hssnadr/HTBX_01Ressources/README.md

# HTBX_01Ressources
Hitbox documentation and file ressources
