hssnadr/HTBX_01Ressources/01_Documentation/Hitbox_Dimensions.jpg

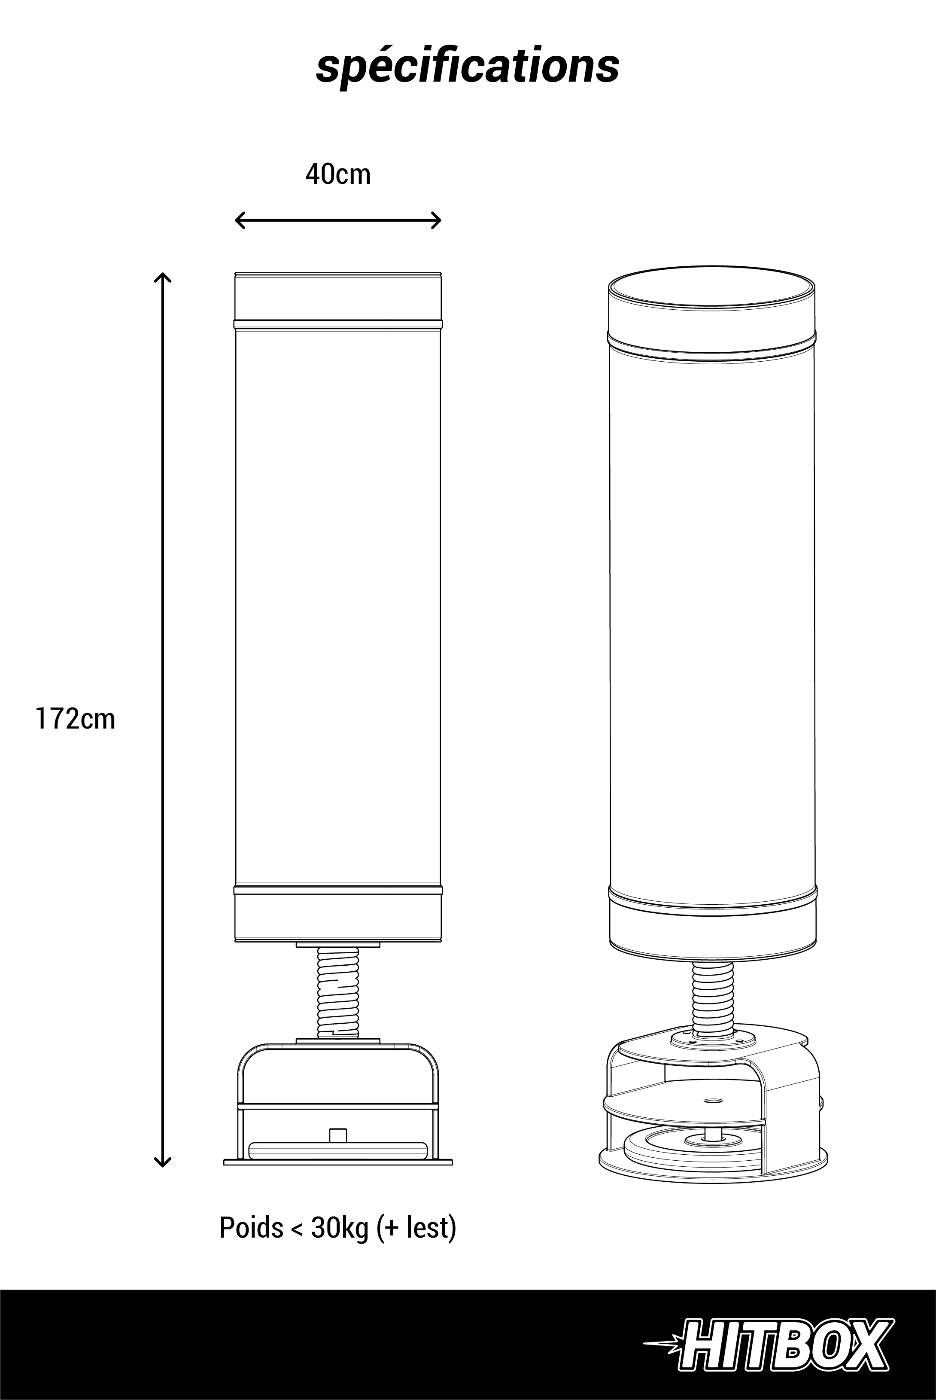
01_Documentation/Hitbox_Dimensions.jpg
