hssnadr/HTBX_01Ressources/01_Documentation/Hitbox_ElectronicsOverview_Display.png

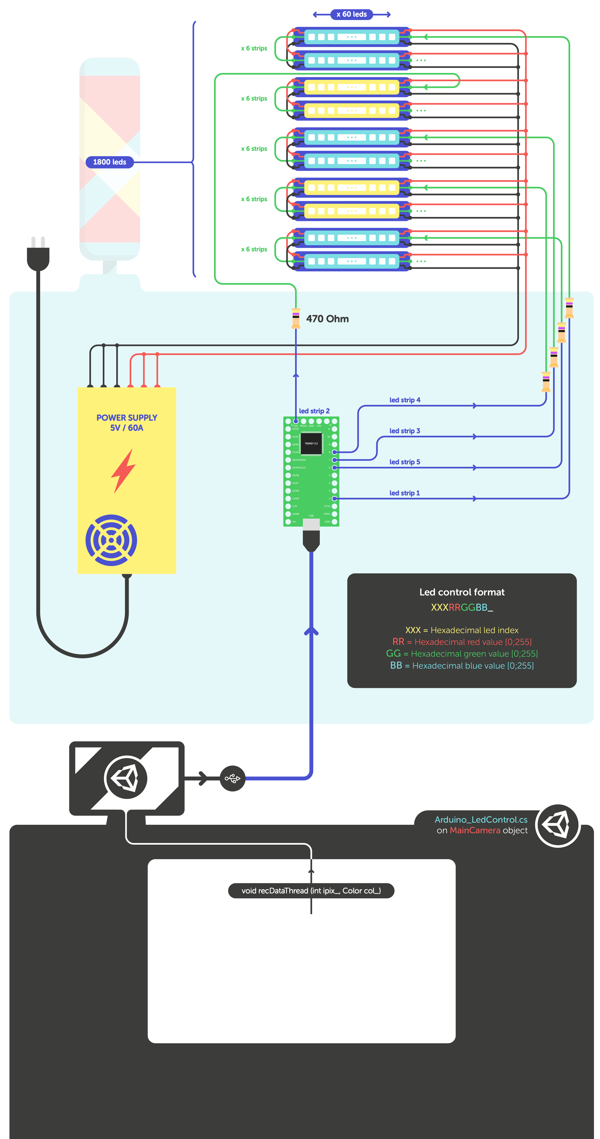
01_Documentation/Hitbox_ElectronicsOverview_Display.png
