hssnadr/HTBX_01Ressources/01_Documentation/Hitbox_ElectronicsOverview_Sensors.png

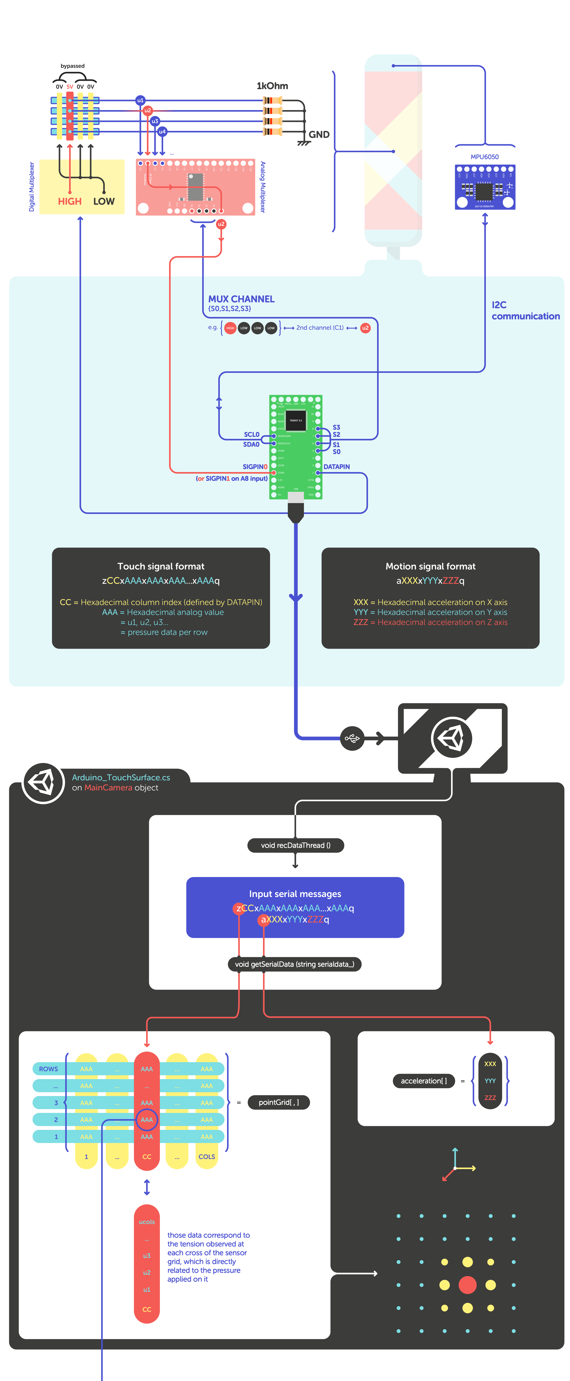
01_Documentation/Hitbox_ElectronicsOverview_Sensors.png
