hssnadr/HTBX_01Ressources/01_Documentation/Hitbox_TechnicOverview.jpg

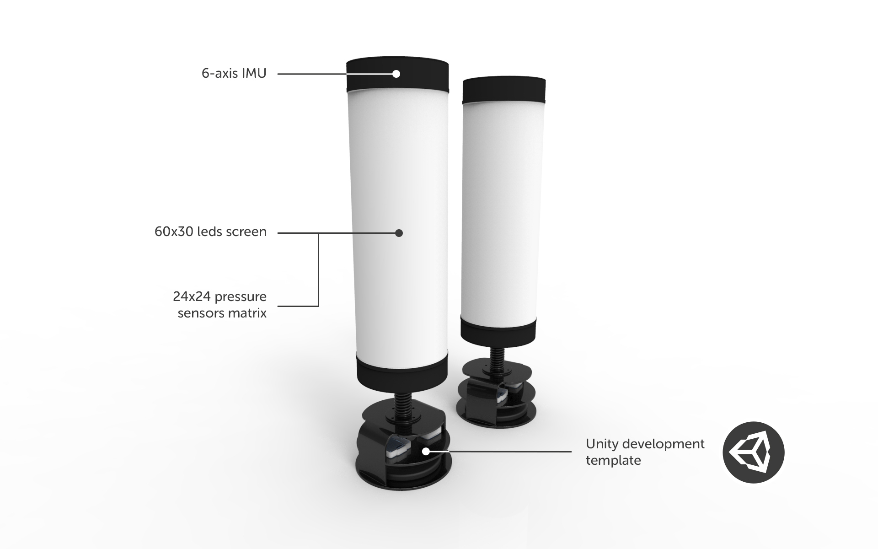
01_Documentation/Hitbox_TechnicOverview.jpg
