hssnadr/HTBX_01Ressources/02_MakingRessources/_CAO/HTBX_EntretoiseTendeurs.stl

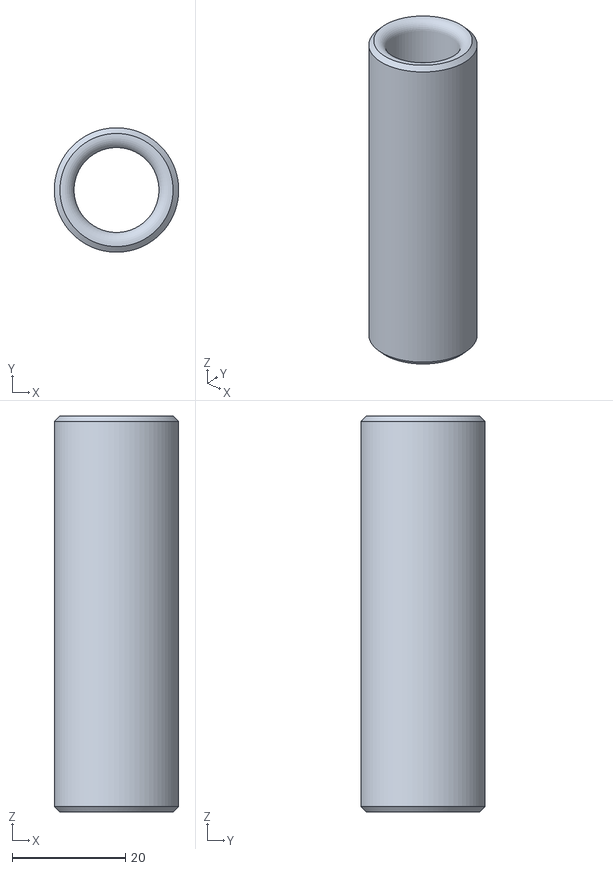
[picture p5: CAD file, 2020-06-24]
02_MakingRessources/_CAO/HTBX_EntretoiseTendeurs.stl
22.0 x 22.0 x 70.0
