hssnadr/HTBX_01Ressources/02_MakingRessources/_CAO/POWER_BOARD/HitBoxV0.31-Powaa.step

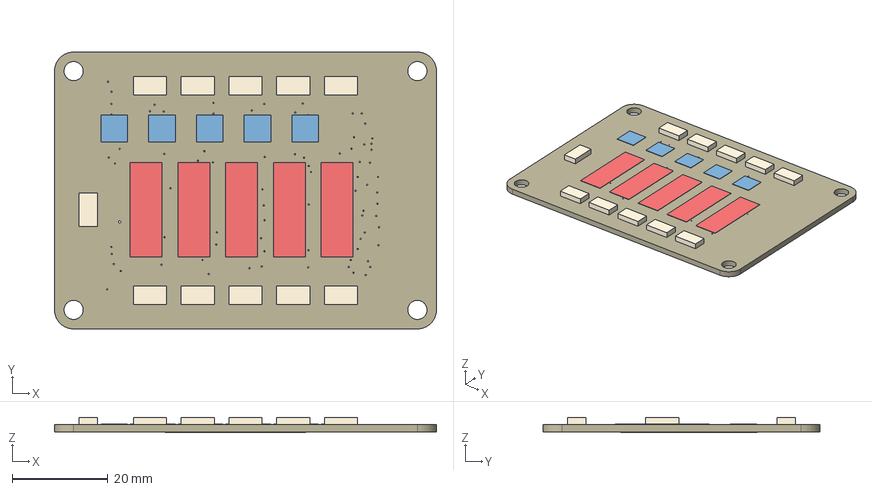
[picture p6: CAD file, 2020-07-23]
02_MakingRessources/_CAO/POWER_BOARD/HitBoxV0.31-Powaa.step
80.0 x 58.0 x 3.18 mm
Board
E2,5-6E x 5
MSTBA2 x 11
LOGO-CRI-NEW-130MMX30MM-TPLACE
FUSE x 5
