hssnadr/HTBX_01Ressources/02_MakingRessources/A_ControlBoardCase/Hitbox_ControlBoardCase_3DPrint.stl

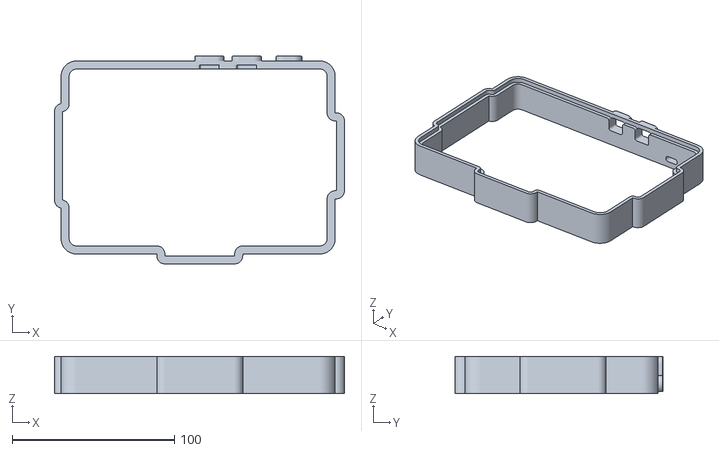
[picture p7: CAD file, 2020-06-19]
02_MakingRessources/A_ControlBoardCase/Hitbox_ControlBoardCase_3DPrint.stl
178.8 x 128.1 x 23.0
