hssnadr/HTBX_01Ressources/02_MakingRessources/B_PowerBoardCase/Hitbox_PowerBoardCase_3DPrint.stl

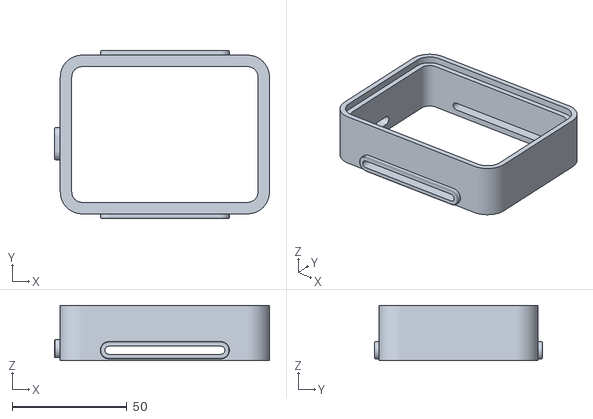
[picture p8: CAD file, 2020-06-19]
02_MakingRessources/B_PowerBoardCase/Hitbox_PowerBoardCase_3DPrint.stl
93.5 x 73.0 x 24.0
