hssnadr/HTBX_01Ressources/02_MakingRessources/C_TopPlatform/TopPlatform_Plexiglass.dxf

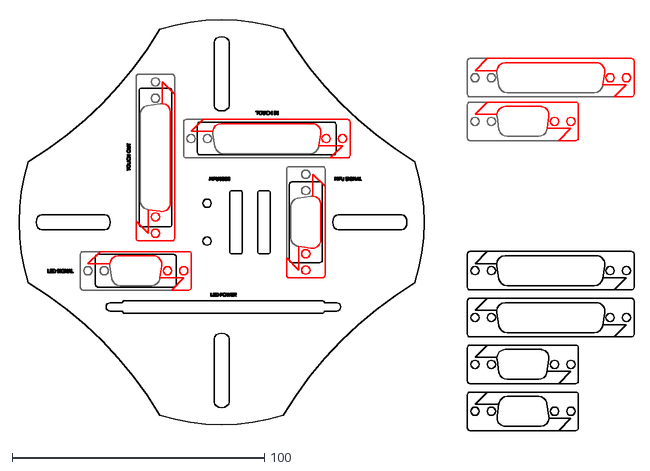
[picture p9: CAD file, 2020-06-22]
02_MakingRessources/C_TopPlatform/TopPlatform_Plexiglass.dxf
244.9 x 164.1
