hssnadr/HTBX_01Ressources/02_MakingRessources/D_BaseCase/Hitbox_LogoCut.dxf

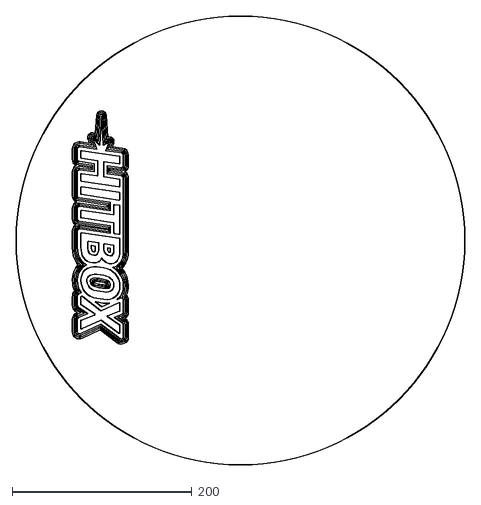
[picture p10: CAD file, 2020-06-24]
02_MakingRessources/D_BaseCase/Hitbox_LogoCut.dxf
500.0 x 500.0
