hssnadr/HTBX_01Ressources/02_MakingRessources/Drawing4.dxf

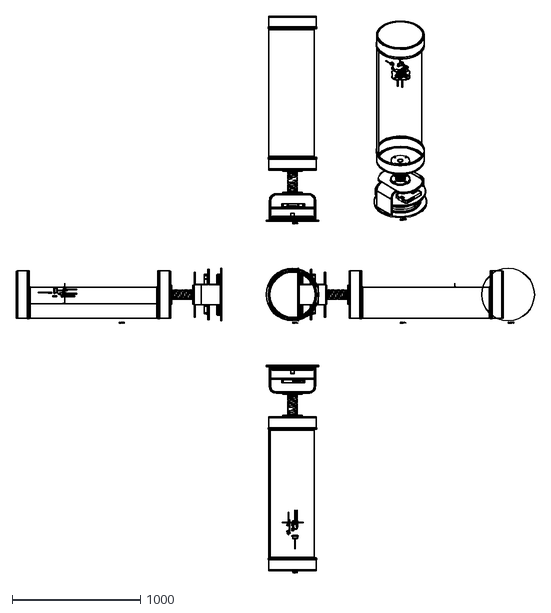
[picture p11: CAD file, 2020-06-22]
02_MakingRessources/Drawing4.dxf
4035.6 x 4339.1
