hssnadr/HTBX_01Ressources/03_ElectronicsRessources/EAGLE/HitBoxV0.31-Powaa.dxf

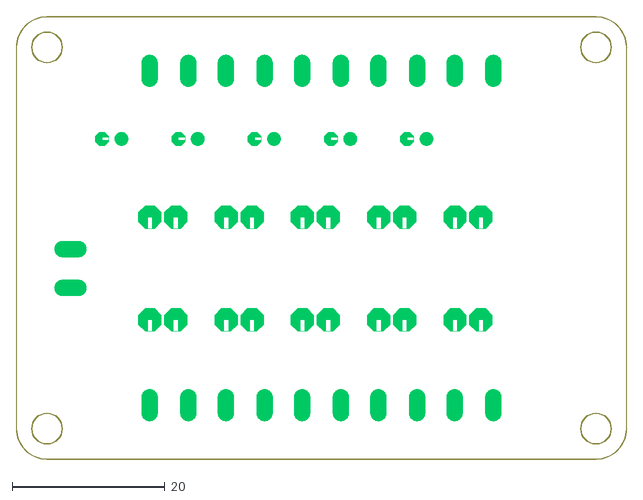
[picture p12: CAD file, 2020-07-23]
03_ElectronicsRessources/EAGLE/HitBoxV0.31-Powaa.dxf
80.1 x 58.1
