hssnadr/HTBX_01Ressources/03_ElectronicsRessources/EAGLE/HitBoxV0.3.dxf

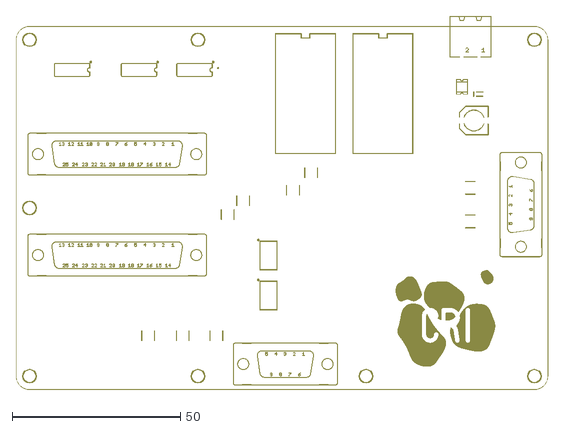
[picture p13: CAD file, 2020-06-19]
03_ElectronicsRessources/EAGLE/HitBoxV0.3.dxf
158.1 x 111.1
