hssnadr/HTBX_01Ressources/(list of files, cad)

Other CAD files:
01_Documentation/Hitbox_CatiaAssemblyPreview/Cases_3DPrint.CATPart
01_Documentation/Hitbox_CatiaAssemblyPreview/Cases_Plexi.CATPart
01_Documentation/Hitbox_CatiaAssemblyPreview/Hitbox_PowerBoardCase.CATPart
01_Documentation/Hitbox_CatiaAssemblyPreview/Hitbox_Preview_Assemble.CATProduct
01_Documentation/Hitbox_CatiaAssemblyPreview/MPU6050_Clone.CATPart
01_Documentation/Hitbox_CatiaAssemblyPreview/Weight.CATPart
02_MakingRessources/DB25_08.CATPart
02_MakingRessources/_CAO/CONTROL_BOARD/ControlBoard.CATProduct
02_MakingRessources/_CAO/CONTROL_BOARD/ControlBoard_CI/100nF.CATPart
02_MakingRessources/_CAO/CONTROL_BOARD/ControlBoard_CI/10uF.CATPart
02_MakingRessources/_CAO/CONTROL_BOARD/ControlBoard_CI/1812L.CATPart
02_MakingRessources/_CAO/CONTROL_BOARD/ControlBoard_CI/1KR.CATPart
02_MakingRessources/_CAO/CONTROL_BOARD/ControlBoard_CI/5.6V.CATPart
02_MakingRessources/_CAO/CONTROL_BOARD/ControlBoard_CI/Board.CATPart
02_MakingRessources/_CAO/CONTROL_BOARD/ControlBoard_CI/CAP-POL-8MMX10MM.CATPart
02_MakingRessources/_CAO/CONTROL_BOARD/ControlBoard_CI/CD74HC4067SM96.CATPart
02_MakingRessources/_CAO/CONTROL_BOARD/ControlBoard_CI/ControlBoard_CI.CATProduct
02_MakingRessources/_CAO/CONTROL_BOARD/ControlBoard_CI/F09VP.CATPart
02_MakingRessources/_CAO/CONTROL_BOARD/ControlBoard_CI/SN74HC595D.CATPart
02_MakingRessources/_CAO/CONTROL_BOARD/DB25_FemaleCI.CATPart
02_MakingRessources/_CAO/CONTROL_BOARD/DB9_FemaleCI.CATPart
02_MakingRessources/_CAO/CONTROL_BOARD/FemaleHeader.CATPart
02_MakingRessources/_CAO/CONTROL_BOARD/Hitbox_ControlBoardCase.CATPart
02_MakingRessources/_CAO/CONTROL_BOARD/PinHeader.CATPart
02_MakingRessources/_CAO/CONTROL_BOARD/Plexiglass_Bottom.CATPart
02_MakingRessources/_CAO/CONTROL_BOARD/Plexiglass_top.CATPart
02_MakingRessources/_CAO/CONTROL_BOARD/PowerBoard_powerwire.CATPart
02_MakingRessources/_CAO/CONTROL_BOARD/Teensy32.CATPart
02_MakingRessources/_CAO/CONTROL_BOARD/TerminalBlockCI.CATPart
02_MakingRessources/_CAO/ExternalFoam_Around.CATPart
02_MakingRessources/_CAO/ExternalFoam_Main.CATPart
02_MakingRessources/_CAO/HITBOX.CATProduct
02_MakingRessources/_CAO/HTBX_EntretoiseTendeurs.CATPart
02_MakingRessources/_CAO/Hitbox_WorkFile_main.CATPart
02_MakingRessources/_CAO/POWER_BOARD/Hitbox_PowerBoardCase.CATPart
02_MakingRessources/_CAO/POWER_BOARD/PB_PlexiglasBottom.CATPart
02_MakingRessources/_CAO/POWER_BOARD/PB_PlexiglasTop.CATPart
02_MakingRessources/_CAO/POWER_BOARD/POWER_BOARD.CATProduct
02_MakingRessources/_CAO/POWER_BOARD/PowerBoard_CI/Board.CATPart
02_MakingRessources/_CAO/POWER_BOARD/PowerBoard_CI/E2,5-6E.CATPart
02_MakingRessources/_CAO/POWER_BOARD/PowerBoard_CI/FUSE.CATPart
02_MakingRessources/_CAO/POWER_BOARD/PowerBoard_CI/LOGO-CRI-NEW-130MMX30MM-TPLACE.CATPart
02_MakingRessources/_CAO/POWER_BOARD/PowerBoard_CI/POWER_BOARD_CI.CATProduct
02_MakingRessources/_CAO/POWER_SUPPLY/POWER_SUPPLY.CATProduct
02_MakingRessources/_CAO/POWER_SUPPLY/PowerSupplySupport_WorkFile.CATPart
02_MakingRessources/_CAO/POWER_SUPPLY/RSP320/FAN_4715KL40WB30_2.1.CATPart
02_MakingRessources/_CAO/POWER_SUPPLY/RSP320/FAN_4715KL40WB30_2.CATPart
02_MakingRessources/_CAO/POWER_SUPPLY/RSP320/M3-7L.1.1.1.CATPart
02_MakingRessources/_CAO/POWER_SUPPLY/RSP320/MOS15.5x10.1.1.1.1.1.1.1.1.1.1.2.1.1.CATPart
02_MakingRessources/_CAO/POWER_SUPPLY/RSP320/PowerSupply_RSP320.CATProduct
02_MakingRessources/_CAO/POWER_SUPPLY/RSP320/VR.1.CATPart
02_MakingRessources/_CAO/POWER_SUPPLY/RSP320/_NPart#308450.CATPart
02_MakingRessources/_CAO/POWER_SUPPLY/RSP320/_NPart#310670.CATPart
02_MakingRessources/_CAO/POWER_SUPPLY/RSP320/_NPart#440520.CATPart
02_MakingRessources/_CAO/POWER_SUPPLY/RSP320/pcb.CATPart
02_MakingRessources/_CAO/POWER_SUPPLY/RSP320/tn.1.1.1.CATPart
02_MakingRessources/_CAO/POWER_SUPPLY/RSP320/uu.3.CATPart
02_MakingRessources/_CAO/POWER_SUPPLY/Tight1.CATPart
02_MakingRessources/_CAO/POWER_SUPPLY/Tight2.CATPart
02_MakingRessources/_CAO/SQUARES_TopPlaform.CATProduct
02_MakingRessources/_CAO/STRUCTURE/Base.CATPart
02_MakingRessources/_CAO/STRUCTURE/CASE/CASE.CATProduct
02_MakingRessources/_CAO/STRUCTURE/CASE/Case_Base.CATPart
02_MakingRessources/_CAO/STRUCTURE/CASE/Case_Logo_Black.CATPart
02_MakingRessources/_CAO/STRUCTURE/CASE/Case_Logo_Blue.CATPart
02_MakingRessources/_CAO/STRUCTURE/CASE/Case_Logo_Red.CATPart
02_MakingRessources/_CAO/STRUCTURE/CASE/Case_Logo_White.CATPart
02_MakingRessources/_CAO/STRUCTURE/CASE/Case_Logo_Yellow.CATPart
02_MakingRessources/_CAO/STRUCTURE/CASE/Case_Plexiglas_Back.CATPart
02_MakingRessources/_CAO/STRUCTURE/CASE/Case_Plexiglas_Front.CATPart
02_MakingRessources/_CAO/STRUCTURE/CASE/Case_Top_Back.CATPart
02_MakingRessources/_CAO/STRUCTURE/CASE/Case_Top_Footprint.CATPart
02_MakingRessources/_CAO/STRUCTURE/CASE/Case_Top_Front.CATPart
02_MakingRessources/_CAO/STRUCTURE/FoamTube.CATPart
02_MakingRessources/_CAO/STRUCTURE/InnerCase_Cut.CATPart
02_MakingRessources/_CAO/STRUCTURE/MainFoam.CATPart
02_MakingRessources/_CAO/STRUCTURE/STRUCTURE.CATProduct
02_MakingRessources/_CAO/STRUCTURE/TopCase_Foam.CATPart
02_MakingRessources/_CAO/STRUCTURE/TopFoamCut.CATPart
02_MakingRessources/_CAO/STRUCTURE/Weight.CATPart
02_MakingRessources/_CAO/SYSTEM/LedStrips_5V_final.CATPart
02_MakingRessources/_CAO/SYSTEM/LedStrips_GND_final.CATPart
02_MakingRessources/_CAO/SYSTEM/LedStrips_Smooth.CATPart
02_MakingRessources/_CAO/SYSTEM/LedStrips_WireControl_final.CATPart
02_MakingRessources/_CAO/SYSTEM/LedStrips_WorkFile.CATPart
02_MakingRessources/_CAO/SYSTEM/MPU6050_Sensor.CATPart
02_MakingRessources/_CAO/SYSTEM/MPU6050_Solders.CATPart
02_MakingRessources/_CAO/SYSTEM/MPU6050_Wires.CATPart
02_MakingRessources/_CAO/SYSTEM/SYSTEM.CATProduct
02_MakingRessources/_CAO/SYSTEM/TouchCols_Solders.CATPart
02_MakingRessources/_CAO/SYSTEM/TouchCols_Strips.CATPart
02_MakingRessources/_CAO/SYSTEM/TouchCols_Wires.CATPart
02_MakingRessources/_CAO/SYSTEM/TouchRows_Solders.CATPart
02_MakingRessources/_CAO/SYSTEM/TouchRows_Strips.CATPart
02_MakingRessources/_CAO/SYSTEM/TouchRows_Support.CATPart
02_MakingRessources/_CAO/SYSTEM/TouchRows_Wires.CATPart
02_MakingRessources/_CAO/SYSTEM/Velostat.CATPart
02_MakingRessources/_CAO/TOP_PLATFORM/DB25_Female.CATPart
02_MakingRessources/_CAO/TOP_PLATFORM/DB25_Male.CATPart
02_MakingRessources/_CAO/TOP_PLATFORM/DB9_Female.CATPart
02_MakingRessources/_CAO/TOP_PLATFORM/DB9_Male.CATPart
02_MakingRessources/_CAO/TOP_PLATFORM/Hitbox_TopPlatform.CATProduct
02_MakingRessources/_CAO/TOP_PLATFORM/Rivet.CATPart
02_MakingRessources/_CAO/TOP_PLATFORM/Square.CATPart
02_MakingRessources/_CAO/TOP_PLATFORM/TerminalBlocks.CATPart
02_MakingRessources/_CAO/TOP_PLATFORM/TopPlatform_WorkFile.CATPart
02_MakingRessources/_CAO/_standard/CapacitorCI.CATPart
02_MakingRessources/_CAO/_standard/FuseBladeCI.CATPart
02_MakingRessources/_CAO/_standard/M4_Nut.CATPart
02_MakingRessources/_CAO/_standard/M4x10_Poelier.CATPart
02_MakingRessources/_CAO/_standard/TerminalBlock10_CI.CATPart
02_MakingRessources/_other/Bag.CATPart
