hssnadr/HTBX_01Ressources/03_ElectronicsRessources/HitBoxx_ElectronicWire_12.pdf

74HC595

74HC595

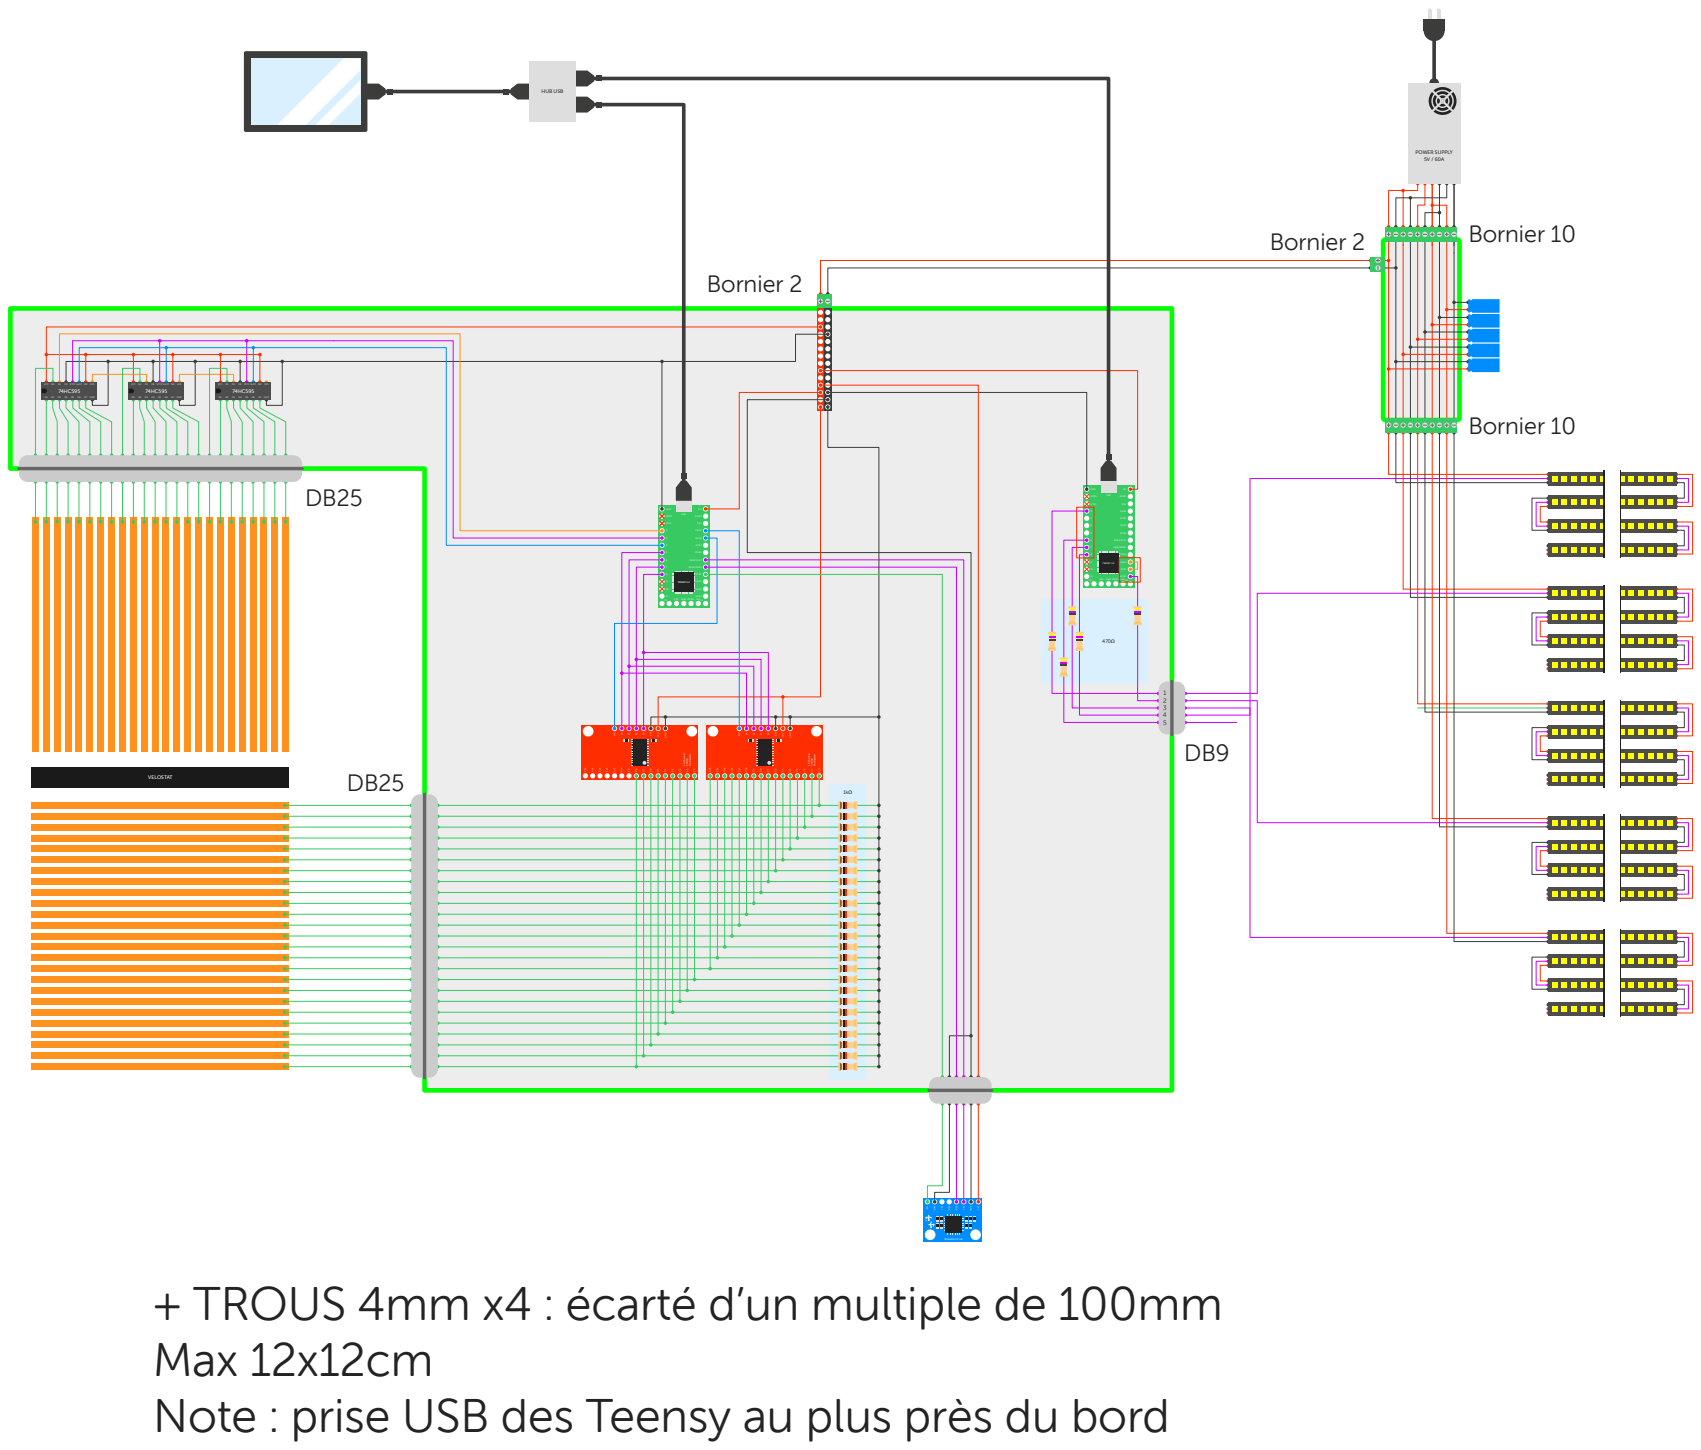
[picture p14: page 1]

+ TROUS 4mm x4 : écarté d’un multiple de 100mm
Max 12x12cm
Note : prise USB des Teensy au plus près du bord
