hssnadr/HTBX_01Ressources/02_MakingRessources/Drawing5.pdf

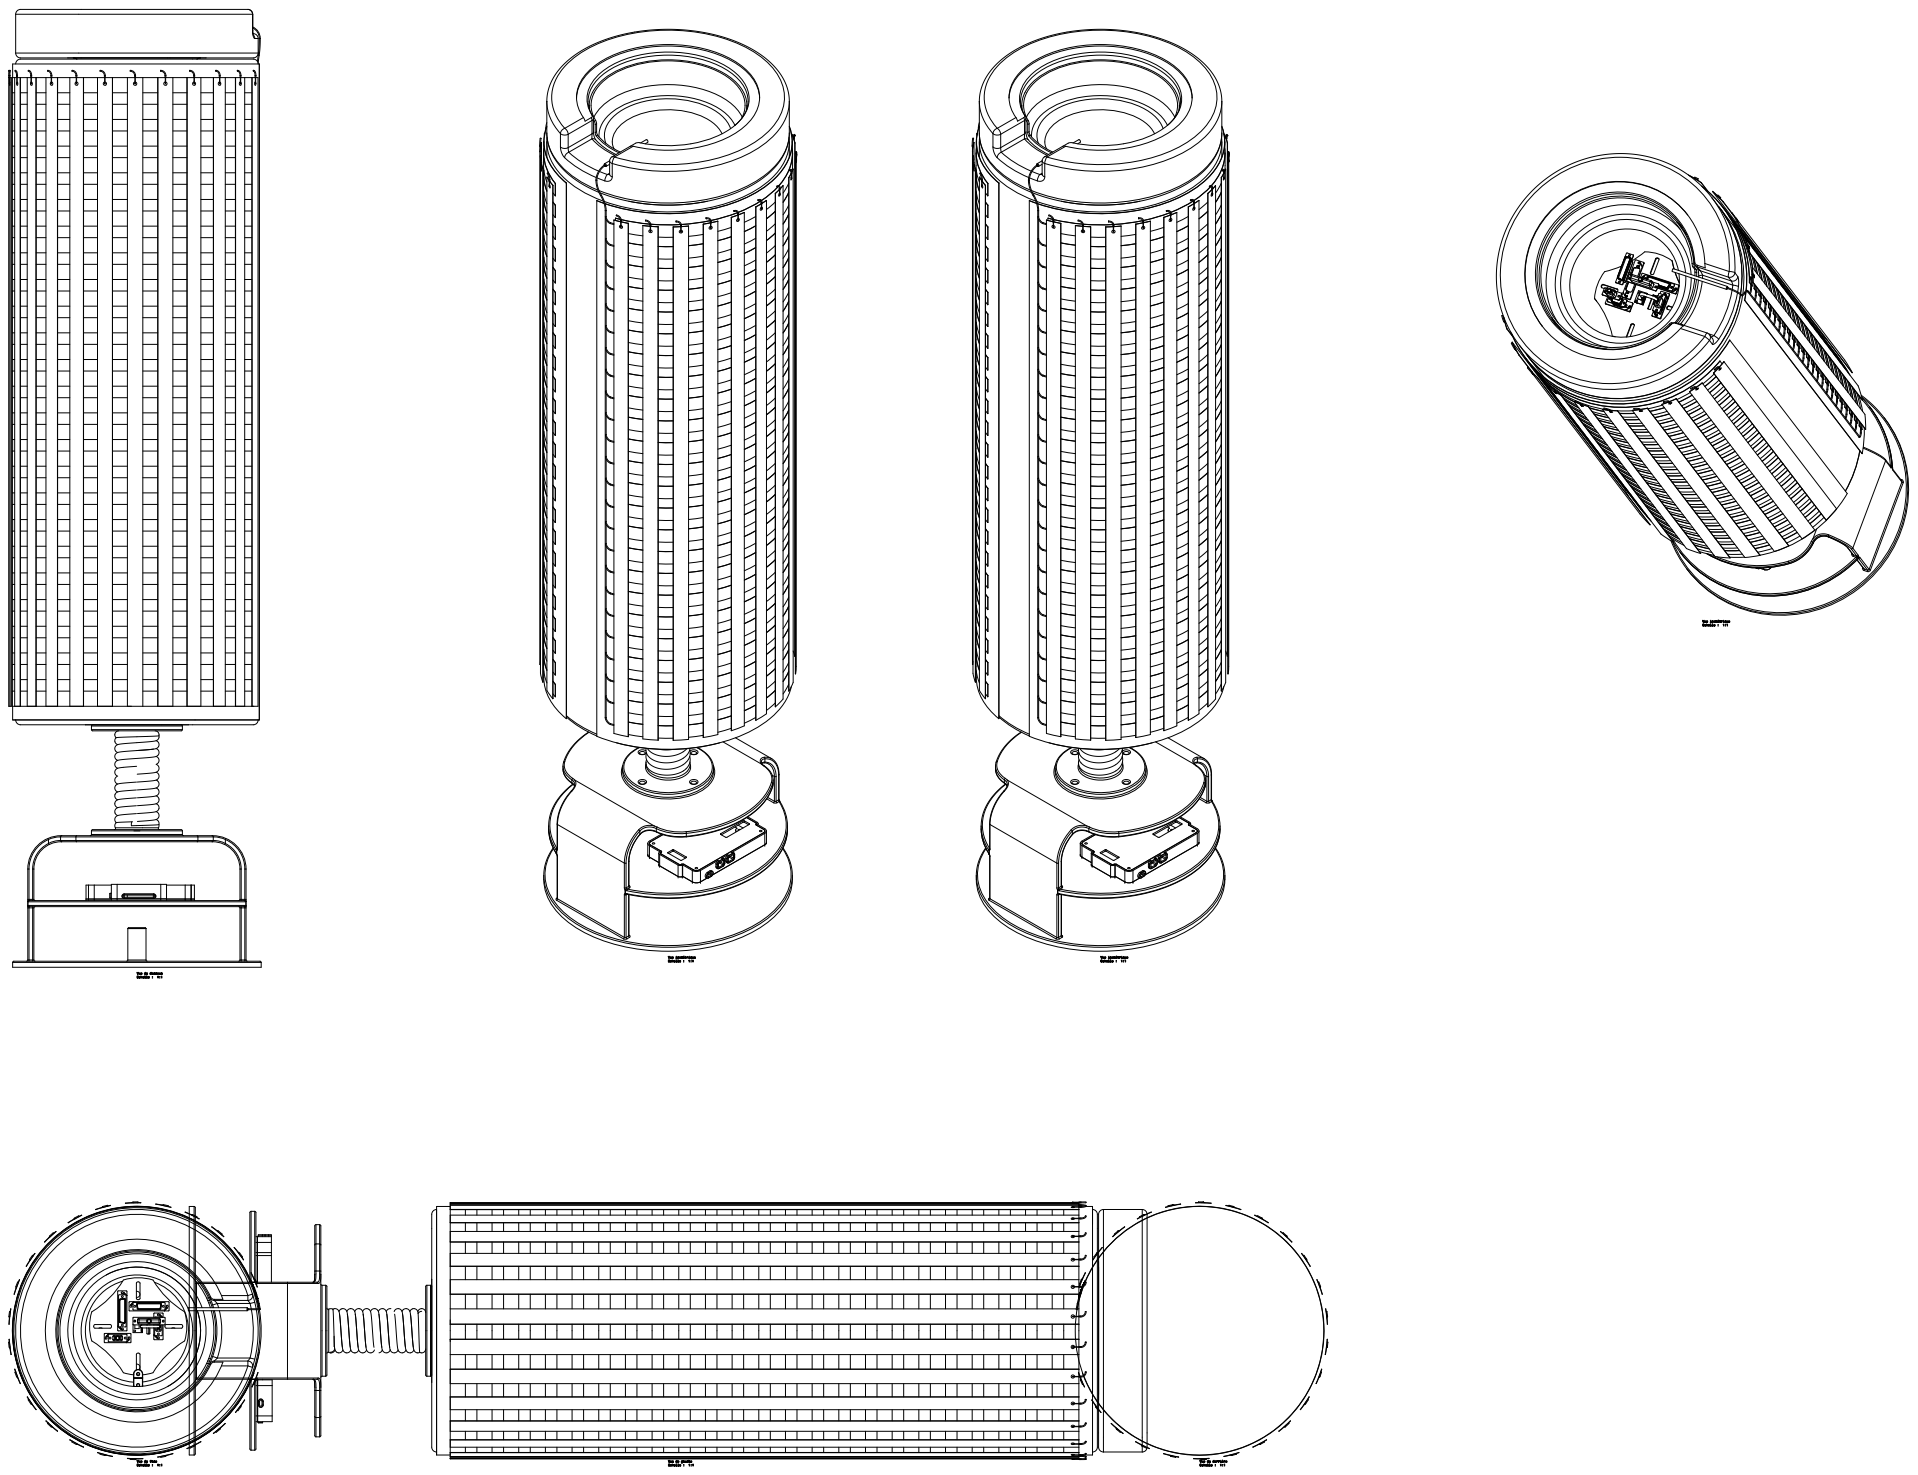
[picture p15: page 1]
