hssnadr/HTBX_01Ressources/02_MakingRessources/Drawing4.pdf

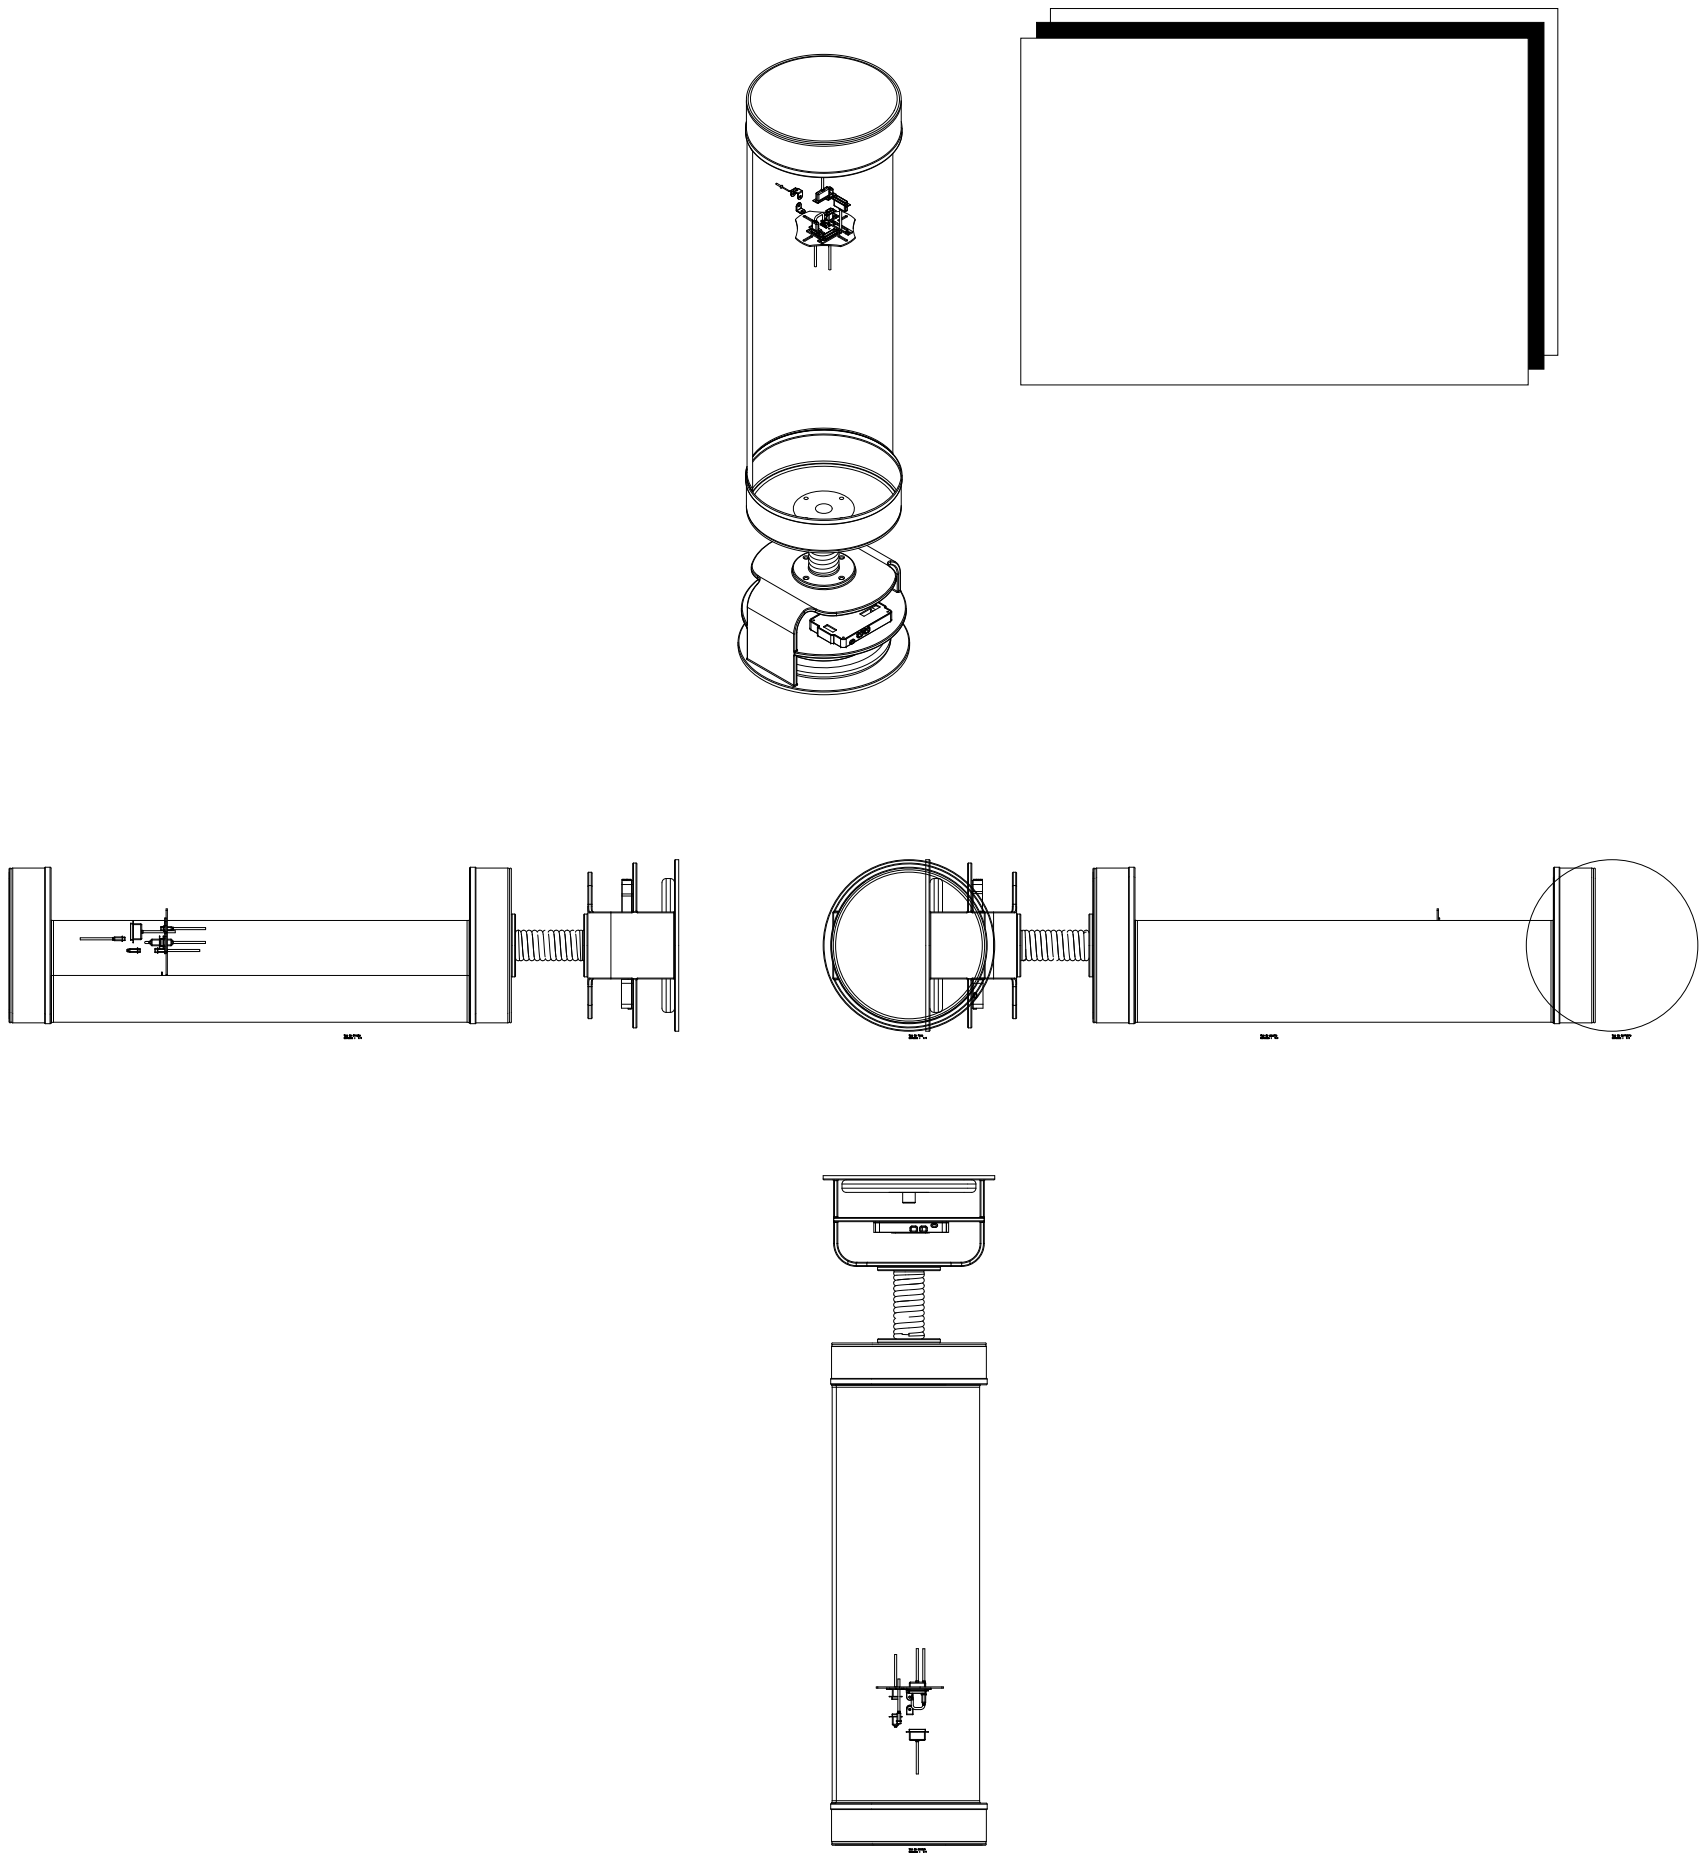
[picture p16: page 1]
