hssnadr/HTBX_01Ressources/03_ElectronicsRessources/EAGLE/HitBoxV0.31-Powaa.brd

## EAGLE design 03_ElectronicsRessources/EAGLE/HitBoxV0.31-Powaa.brd (2020-06-19)

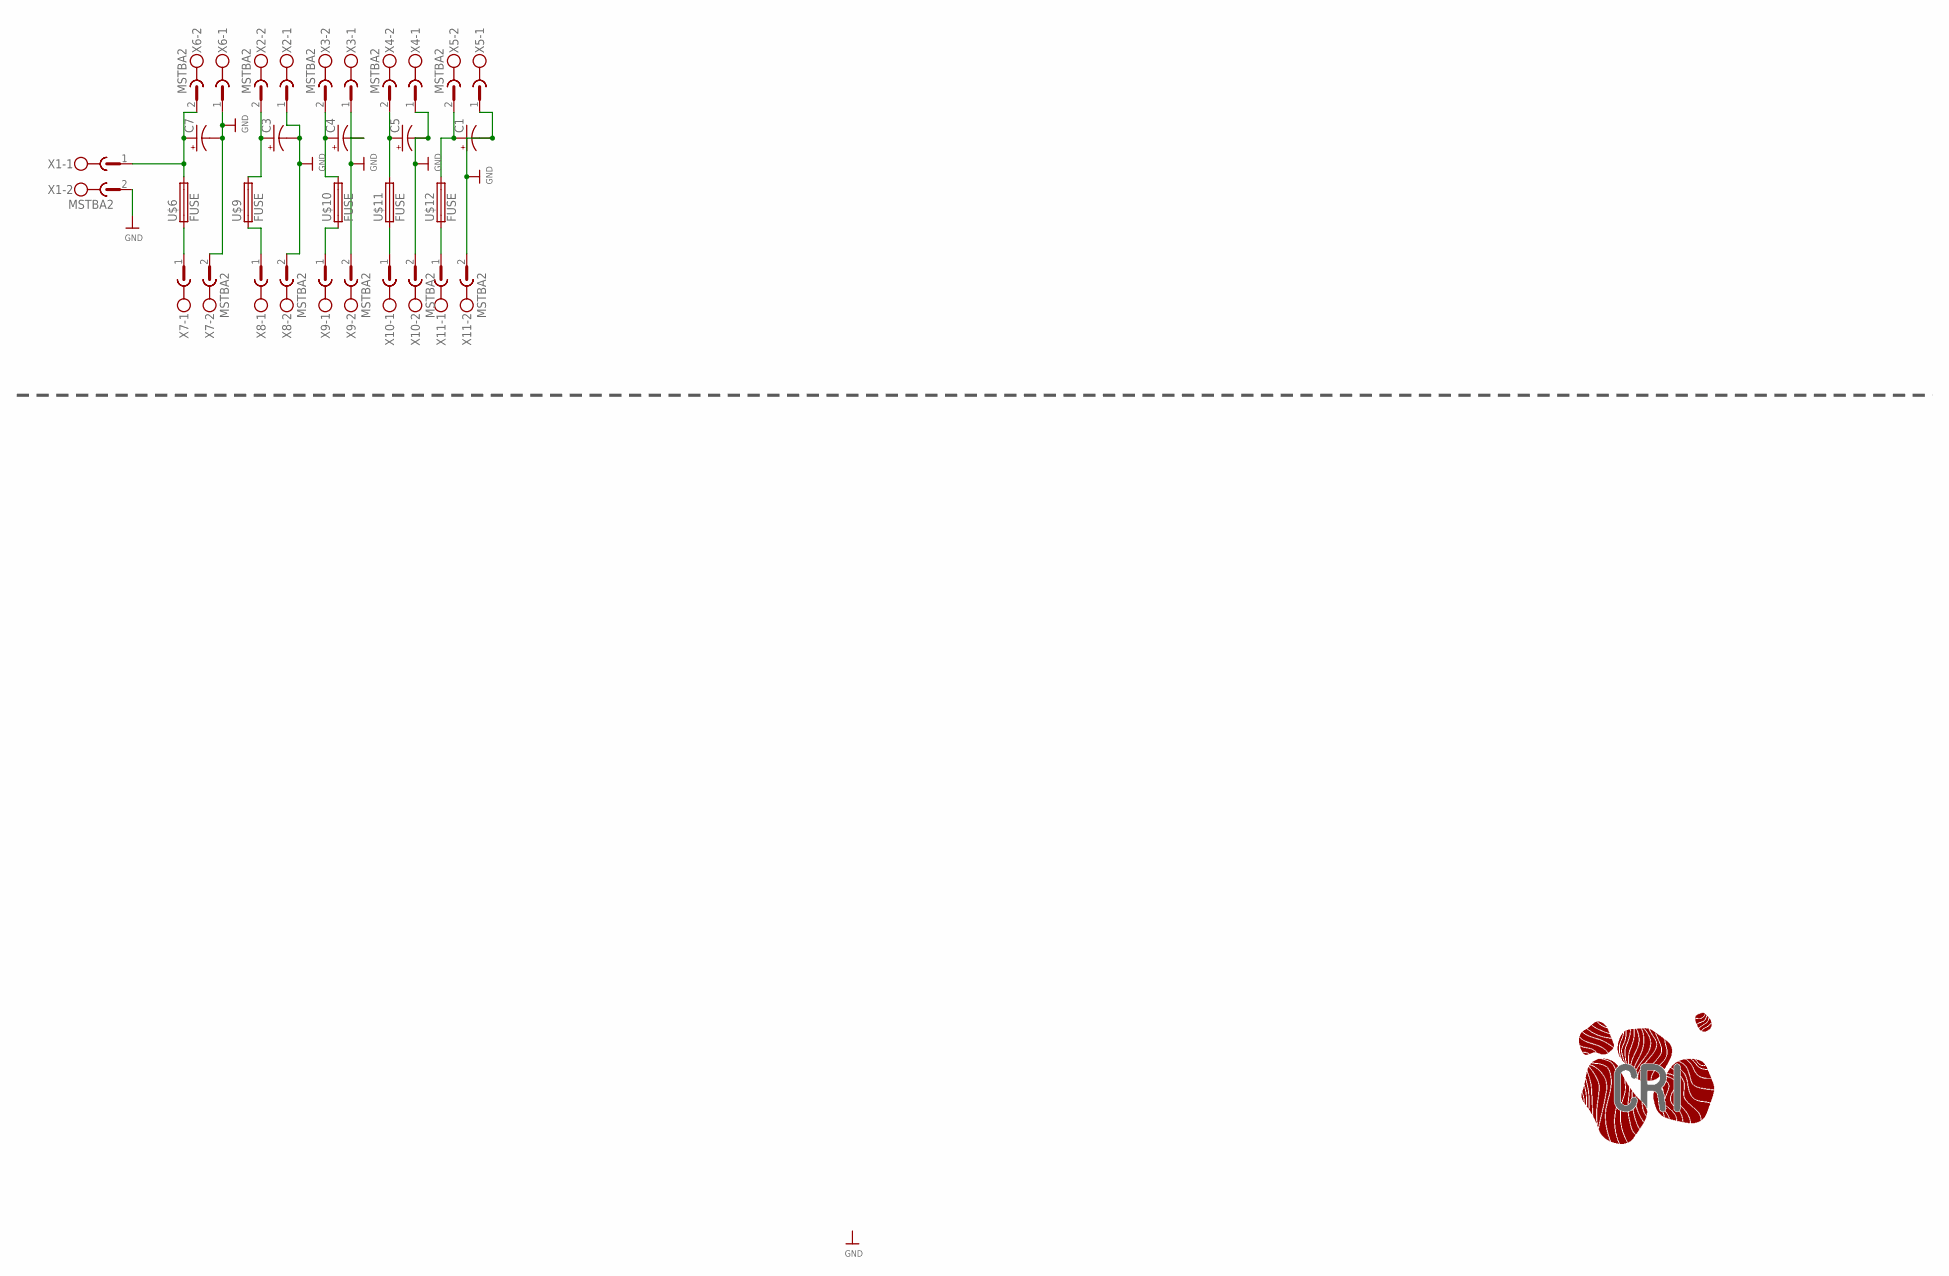
[picture p17: schematic HitBoxV0.31-Powaa.sch]

Parts:
C1, C3, C4, C5, C7: CPOL-USE2,5-6E; E2,5-6E
U$6, U$9, U$10, U$11, U$12: FUSE; KEYSTONE-AUTO-FUSE
U$7: LOGO-CRI-NEW-130MMX30MM-TPLACE; LOGO_CRI-NEW-BMP30MM-TOP
X1, X2, X3, X4, X5, X6, X7, X8, X9, X10, X11: MSTBA2

Connections:
GND: C1.-, C3.-, C4.-, C5.-, C7.-, X1.2, X2.1, X3.1, X4.1, X5.1, X6.1, X7.2, X8.2, X9.2, X10.2, X11.2
unnamed: C7.+, U$6.P$3 (2), U$6.P$4 (2), X1.1, X6.2
unnamed: C3.+, U$9.P$3 (2), U$9.P$4 (2), X2.2
unnamed: C4.+, U$10.P$3 (2), U$10.P$4 (2), X3.2
unnamed: C5.+, U$11.P$3 (2), U$11.P$4 (2), X4.2
unnamed: C1.+, U$12.P$3 (2), U$12.P$4 (2), X5.2
unnamed: U$6.P$1 (1), U$6.P$2 (1), X7.1
unnamed: U$9.P$1 (1), U$9.P$2 (1), X8.1
unnamed: U$10.P$1 (1), U$10.P$2 (1), X9.1
unnamed: U$11.P$1 (1), U$11.P$2 (1), X10.1
unnamed: U$12.P$1 (1), U$12.P$2 (1), X11.1

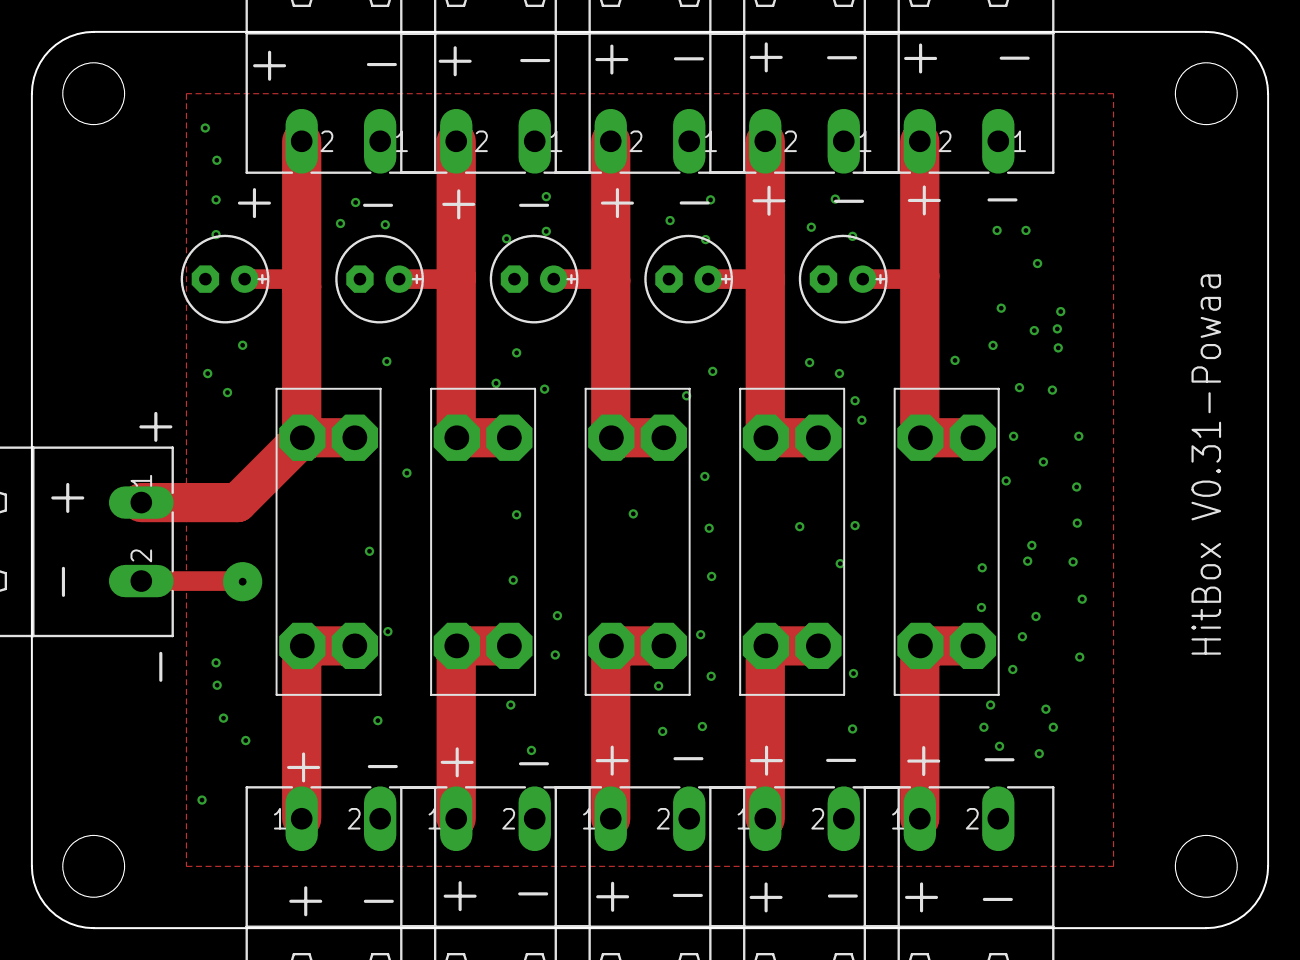
[picture p18: board HitBoxV0.31-Powaa.brd from above]

Board: 2 copper layers, 80.0 x 58.0 mm, 22 parts (1 on the bottom side), 11 nets.
