hssnadr/HTBX_01Ressources/03_ElectronicsRessources/EAGLE/HitBoxV0.3.brd

## EAGLE design 03_ElectronicsRessources/EAGLE/HitBoxV0.3.brd (2020-06-19)

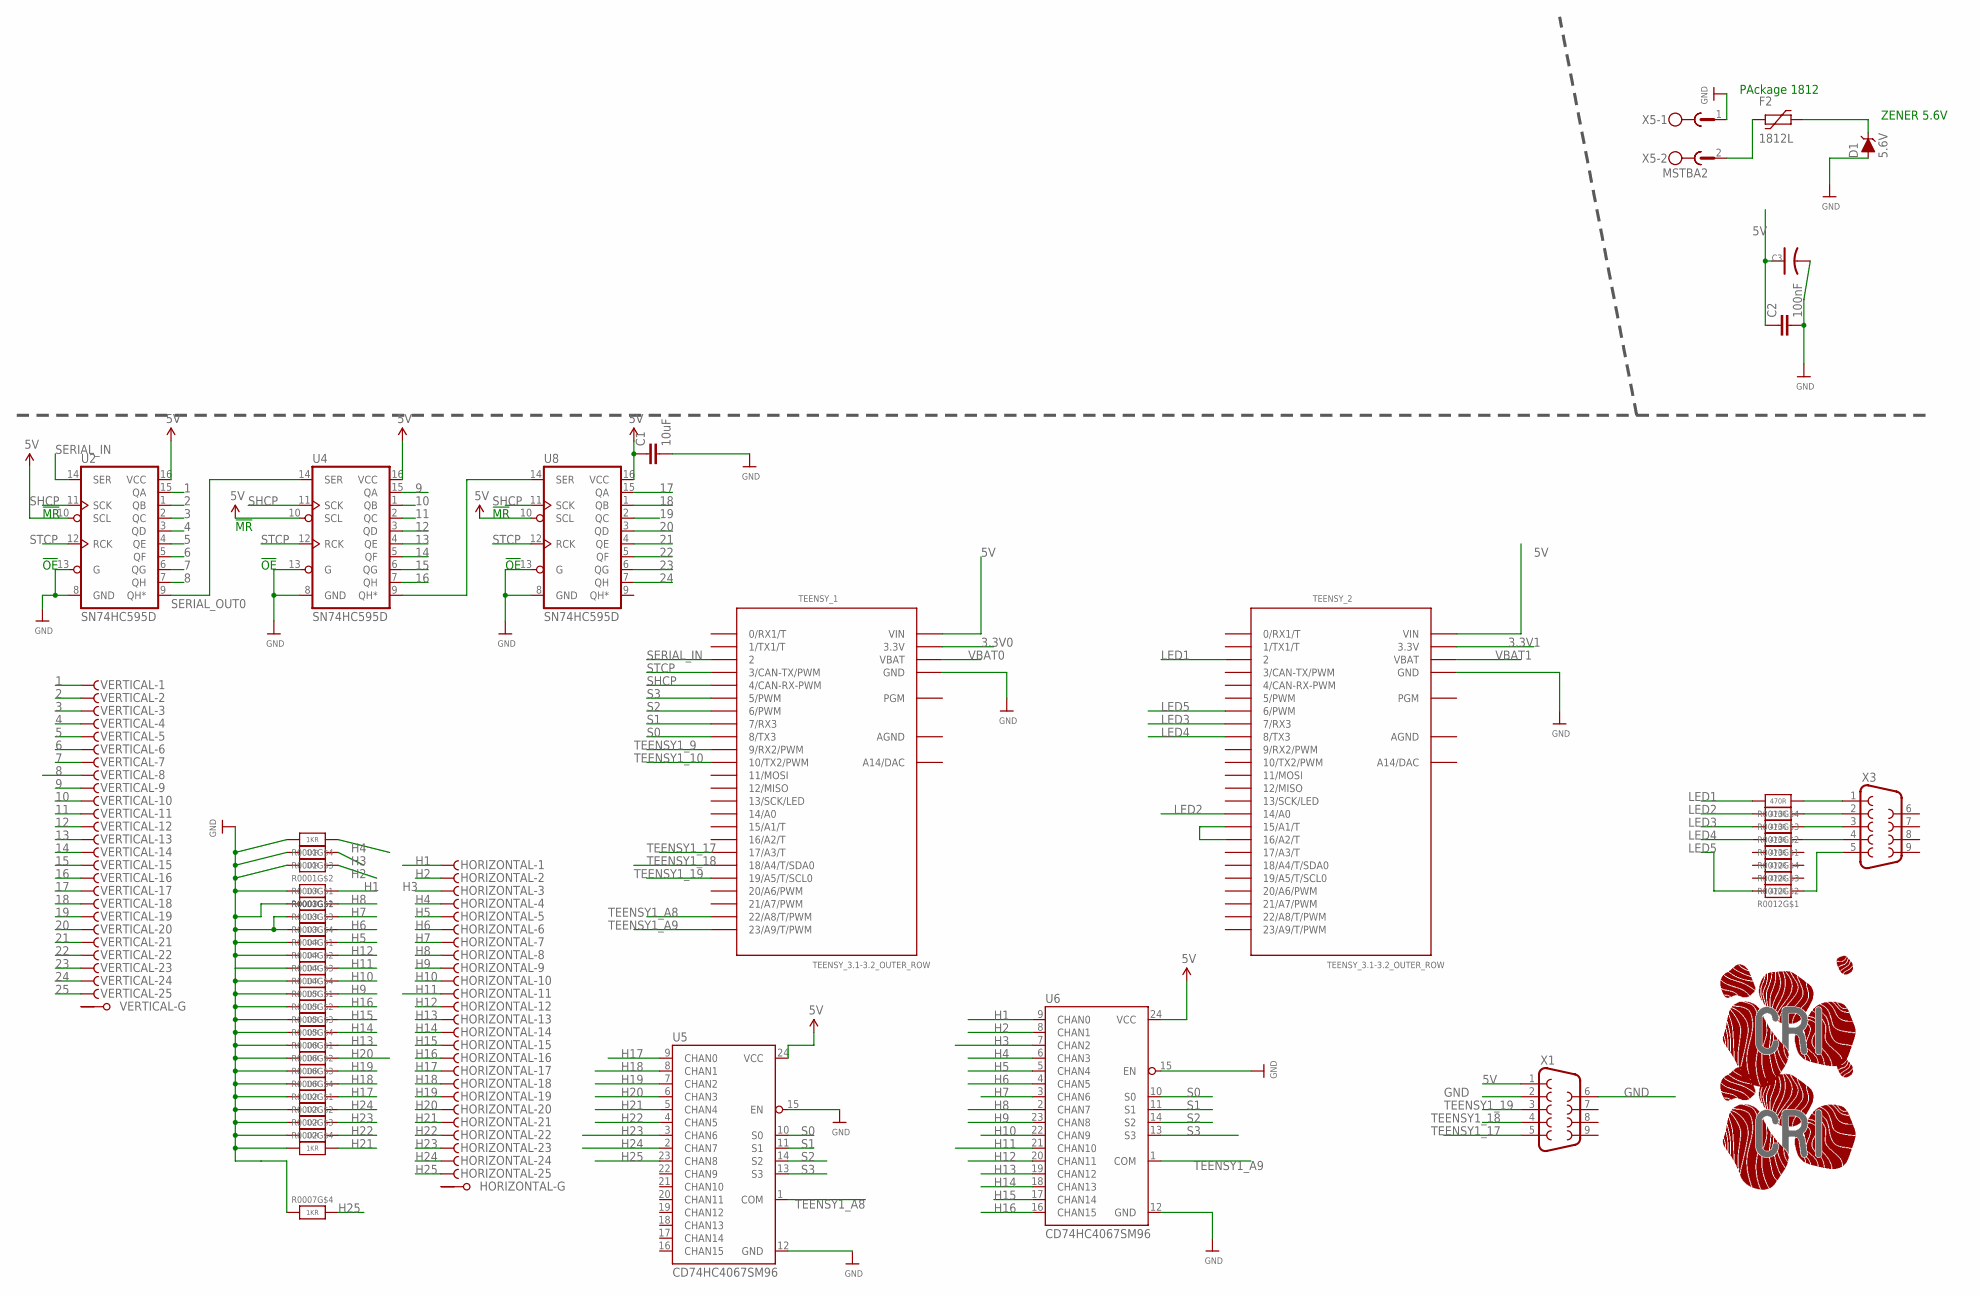
[picture p19: schematic HitBoxV0.3.sch]

Parts:
C1: 10uF; 0402-CAP
C2: 100nF; C0805
C3: C-POLAR8MMX10MM; CAP-POL-8MMX10MM
D1: 5.6V; SOD-323
F2: 1812L
HORIZONTAL: F25VPS; F25VP
R0001, R0002, R0003, R0004, R0005, R0006, R0007: 1KR; RESPACK_4X0603
R0012, R0013: 470R; RESPACK_4X0603
TEENSY_1, TEENSY_2: TEENSY_3.1-3.2_OUTER_ROW; TEENSY_3.0-3.2&LC_OUTER_ROW
U2, U4, U8: SN74HC595D; SO16
U5, U6: CD74HC4067SM96; SSOP24
U$8: LOGO-CRI-NEW-150MM-TOP-TPLACE; LOGO_CRI-NEW-BMP50MM-TOP
U$10: LOGO-CRI-NEW-130MMX30MM-TPLACE; LOGO_CRI-NEW-BMP30MM-TOP
VERTICAL: F25VPS; F25VP
X1, X3: F09VP
X5: MSTBA2

Connections:
1: U2.15 (QA), VERTICAL.1 (F)
2: U2.1 (QB), VERTICAL.2 (F)
3: U2.2 (QC), VERTICAL.3 (F)
3.3V0: TEENSY_1.3.3V, TEENSY_1.3.3V1 (3.3V)
3.3V1: TEENSY_2.3.3V, TEENSY_2.3.3V1 (3.3V)
4: U2.3 (QD), VERTICAL.4 (F)
5: U2.4 (QE), VERTICAL.5 (F)
5V: C1.1, C2.1, C3.+ (1), D1.C, F2.P$2 (2), TEENSY_1.VIN, TEENSY_2.VIN, U2.10 (SCL), U2.16 (VCC), U4.10 (SCL), U4.16 (VCC), U5.24 (VCC), U6.24 (VCC), U8.10 (SCL), U8.16 (VCC), X1.1
6: U2.5 (QF), VERTICAL.6 (F)
7: U2.6 (QG), VERTICAL.7 (F)
8: U2.7 (QH), VERTICAL.8 (F)
9: U4.15 (QA), VERTICAL.9 (F)
10: U4.1 (QB), VERTICAL.10 (F)
11: U4.2 (QC), VERTICAL.11 (F)
12: U4.3 (QD), VERTICAL.12 (F)
13: U4.4 (QE), VERTICAL.13 (F)
14: U4.5 (QF), VERTICAL.14 (F)
15: U4.6 (QG), VERTICAL.15 (F)
16: U4.7 (QH), VERTICAL.16 (F)
17: U8.15 (QA), VERTICAL.17 (F)
18: U8.1 (QB), VERTICAL.18 (F)
19: U8.2 (QC), VERTICAL.19 (F)
20: U8.3 (QD), VERTICAL.20 (F)
21: U8.4 (QE), VERTICAL.21 (F)
22: U8.5 (QF), VERTICAL.22 (F)
23: U8.6 (QG), VERTICAL.23 (F)
24: U8.7 (QH), VERTICAL.24 (F)
25: VERTICAL.25 (F)
AGND: TEENSY_1.AGND, TEENSY_2.AGND
GND: C1.2, C2.2, C3.- (2), D1.A, R0001.5 (2), R0001.6 (2), R0001.7 (2), R0001.8 (2), R0002.1, R0002.2 (1), R0002.3 (1), R0002.4 (1), R0003.1, R0003.2 (1), R0003.3 (1), R0003.4 (1), R0004.1, R0004.2 (1), R0004.3 (1), R0004.4 (1), R0005.1, R0005.2 (1), R0005.3 (1), R0005.4 (1), R0006.1, R0006.2 (1), R0006.3 (1), R0006.4 (1), R0007.4 (1), TEENSY_1.GND, TEENSY_1.GND1 (GND), TEENSY_2.GND, TEENSY_2.GND1 (GND), U2.8 (GND), U2.13 (G), U4.8 (GND), U4.13 (G), U5.12 (GND), U5.15 (EN), U6.12 (GND), U6.15 (EN), U8.8 (GND), U8.13 (G), X1.2, X1.6, X5.1
H1: HORIZONTAL.1 (F), R0001.1, U6.9 (CHAN0)
H2: HORIZONTAL.2 (F), R0001.2 (1), U6.8 (CHAN1)
H3: HORIZONTAL.3 (F), R0001.3 (1), U6.7 (CHAN2)
H4: HORIZONTAL.4 (F), R0001.4 (1), U6.6 (CHAN3)
H5: HORIZONTAL.5 (F), R0003.5 (2), U6.5 (CHAN4)
H6: HORIZONTAL.6 (F), R0003.6 (2), U6.4 (CHAN5)
H7: HORIZONTAL.7 (F), R0003.7 (2), U6.3 (CHAN6)
H8: HORIZONTAL.8 (F), R0003.8 (2), U6.2 (CHAN7)
H9: HORIZONTAL.9 (F), R0004.5 (2), U6.23 (CHAN8)
H10: HORIZONTAL.10 (F), R0004.6 (2), U6.22 (CHAN9)
H11: HORIZONTAL.11 (F), R0004.7 (2), U6.21 (CHAN10)
H12: HORIZONTAL.12 (F), R0004.8 (2), U6.20 (CHAN11)
H13: HORIZONTAL.13 (F), R0005.5 (2), U6.19 (CHAN12)
H14: HORIZONTAL.14 (F), R0005.6 (2), U6.18 (CHAN13)
H15: HORIZONTAL.15 (F), R0005.7 (2), U6.17 (CHAN14)
H16: HORIZONTAL.16 (F), R0005.8 (2), U6.16 (CHAN15)
H17: HORIZONTAL.17 (F), R0006.5 (2), U5.9 (CHAN0)
H18: HORIZONTAL.18 (F), R0006.6 (2), U5.8 (CHAN1)
H19: HORIZONTAL.19 (F), R0006.7 (2), U5.7 (CHAN2)
H20: HORIZONTAL.20 (F), R0006.8 (2), U5.6 (CHAN3)
H21: HORIZONTAL.21 (F), R0002.5 (2), U5.5 (CHAN4)
H22: HORIZONTAL.22 (F), R0002.6 (2), U5.4 (CHAN5)
H23: HORIZONTAL.23 (F), R0002.7 (2), U5.3 (CHAN6)
H24: HORIZONTAL.24 (F), R0002.8 (2), U5.2 (CHAN7)
H25: HORIZONTAL.25 (F), R0007.5 (2), U5.23 (CHAN8)
LED1: R0013.5 (2), TEENSY_2.2
LED2: R0013.6 (2), TEENSY_2.14/A0
LED3: R0013.7 (2), TEENSY_2.7 (7/RX3)
LED4: R0013.8 (2), TEENSY_2.8 (8/TX3)
LED5: R0012.8 (2), TEENSY_2.6 (6/PWM)
unnamed: R0013.4 (1), X3.1
unnamed: R0013.3 (1), X3.2
unnamed: U4.9 (QH*), U8.14 (SER)
unnamed: R0013.2 (1), X3.3
unnamed: R0013.1, X3.4
unnamed: TEENSY_2.15/A1 (15/A1/T), TEENSY_2.16/A2 (16/A2/T)
unnamed: F2.P$1 (1), X5.2
unnamed: R0012.1, X3.5
S0: TEENSY_1.8 (8/TX3), U5.10 (S0), U6.10 (S0)
S1: TEENSY_1.7 (7/RX3), U5.11 (S1), U6.11 (S1)
S2: TEENSY_1.6 (6/PWM), U5.14 (S2), U6.14 (S2)
S3: TEENSY_1.5 (5/PWM), U5.13 (S3), U6.13 (S3)
SERIAL_IN: TEENSY_1.2, U2.14 (SER)
SERIAL_OUT0: U2.9 (QH*), U4.14 (SER)
SHCP: TEENSY_1.4 (4/CAN-RX-PWM), U2.11 (SCK), U4.11 (SCK), U8.11 (SCK)
STCP: TEENSY_1.3 (3/CAN-TX/PWM), U2.12 (RCK), U4.12 (RCK), U8.12 (RCK)
TEENSY1_9: TEENSY_1.9 (9/RX2/PWM)
TEENSY1_10: TEENSY_1.10 (10/TX2/PWM)
TEENSY1_17: TEENSY_1.17/A3 (17/A3/T), X1.5
TEENSY1_18: TEENSY_1.18/A4 (18/A4/T/SDA0), X1.4
TEENSY1_19: TEENSY_1.19/A5 (19/A5/T/SCL0), X1.3
TEENSY1_A8: TEENSY_1.22/A8 (22/A8/T/PWM), U5.1 (COM)
TEENSY1_A9: TEENSY_1.23/A9 (23/A9/T/PWM), U6.1 (COM)
VBAT0: TEENSY_1.VBAT
VBAT1: TEENSY_2.VBAT

Notes on the sheet:
!OE!
!MR!
PAckage 1812
ZENER 5.6V

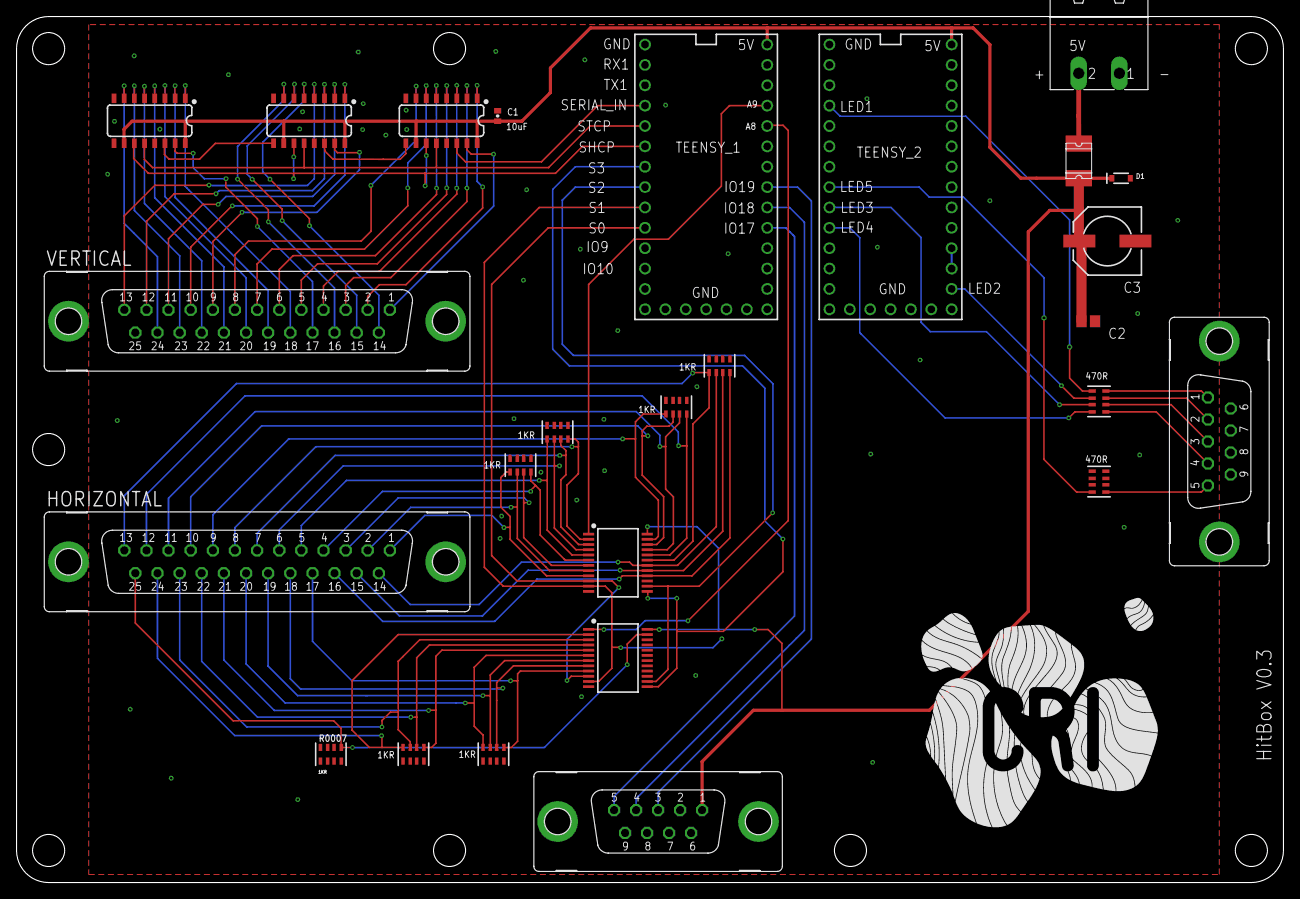
[picture p20: board HitBoxV0.3.brd from above]

Board: 2 copper layers, 158.0 x 108.0 mm, 28 parts (1 on the bottom side), 80 nets.
