hssnadr/HTBX_01Ressources/(commit log)

2020-06-22 hitbox assembly init
    [DB9_Female.CATPart, Drawing4.dxf, Hitbox_Assembly.CATProduct, Hitbox_PowerBoardCase.CATPart, Weight.CATPart]
2020-06-24 update Catia
    [HTBX_EntretoiseTendeurs.CATPart, HTBX_EntretoiseTendeurs.stl, Hitbox_Assembly.CATProduct, Hitbox_LogoCut.dxf, Hitbox_PowerBoardCase.CATPart]
2020-06-25 update Hitbox assembly
    [DB25_Female.CATPart, Hitbox_Assembly.CATProduct, TouchSensors_01rows.CATPart]
2020-08-21 clean cable 1
    [HITBOX.CATProduct, Hitbox_TopPlatform.CATProduct, STRUCTURE.CATProduct, SYSTEM.CATProduct]
2020-08-25 catia clean
    [ControlBoard.CATProduct, HITBOX.CATProduct, Hitbox_TopPlatform.CATProduct, MPU6050.CATPart, POWER_BOARD.CATProduct, POWER_BOARD_CI.CATProduct, PowerBoard_powerwire.CATPart, STRUCTURE.CATProduct]
2020-08-26 Revert "testfdp"
    This reverts commit c0a527d713aa96d3e811c7f13a6af79030394948.
    [CASE.CATProduct, Case_Logo_Red.CATPart, Case_Logo_Yellow.CATPart, Case_Top_Back.CATPart, Case_Top_Front.CATPart, HITBOX.CATProduct, Hitbox_WorkFile_main.CATPart, InnerCase_Cut.CATPart]
2020-08-26 Revert "Revert "testfdp""
    This reverts commit ab473c10f75899fee0d607c167fabfc2b384264c.
    [CASE.CATProduct, Case_Logo_Red.CATPart, Case_Logo_Yellow.CATPart, Case_Top_Back.CATPart, Case_Top_Front.CATPart, HITBOX.CATProduct, Hitbox_WorkFile_main.CATPart, InnerCase_Cut.CATPart]
2020-08-28 catia cut 1
    [ControlBoard.CATProduct, DB25_Female.CATPart, DB25_Male.CATPart, DB9_Female.CATPart, HITBOX.CATProduct, Hitbox_TopPlatform.CATProduct, Hitbox_WorkFile_main.CATPart, InnerCase_Cut.CATPart]
